KhaledAbuMustafa/esp32-smart-irrigation/firmware/smart_irrigation/secrets.example.h

// Template: copy this file, rename it to "secrets.h" and enter your own credentials.
// secrets.h is listed in .gitignore and will not be uploaded to GitHub.
#pragma once

#define WIFI_SSID     "YOUR_WIFI"
#define WIFI_PASSWORD "YOUR_PASSWORD"
#define OTA_PASSWORD  "CHOOSE_AN_OTA_PASSWORD"   // protects over-the-air updates
